Anish-A-18/Wireless-Power-Transmission/Presentation+Video/quadFinal.jpg

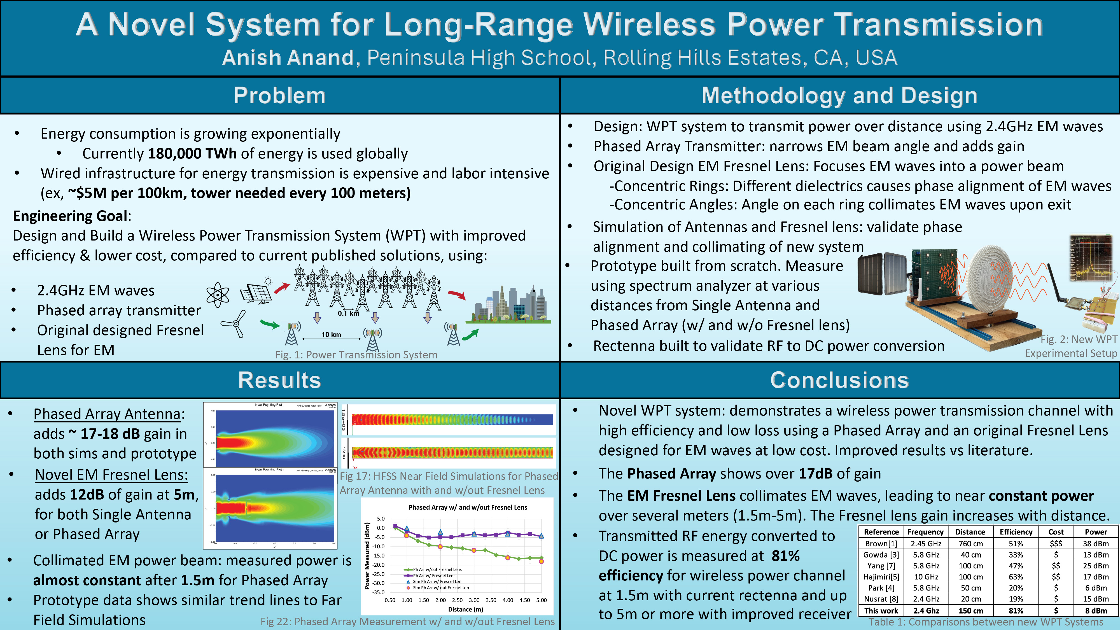
Presentation+Video/quadFinal.jpg
