Anish-A-18/Wireless-Power-Transmission/Presentation+Video/Video.md

Watch the video (https://youtu.be/sPy0BPeNYaU)
