Anish-A-18/Wireless-Power-Transmission/Presentation+Video/WPT_ISEFpreziFINAL.pdf

## PHY031

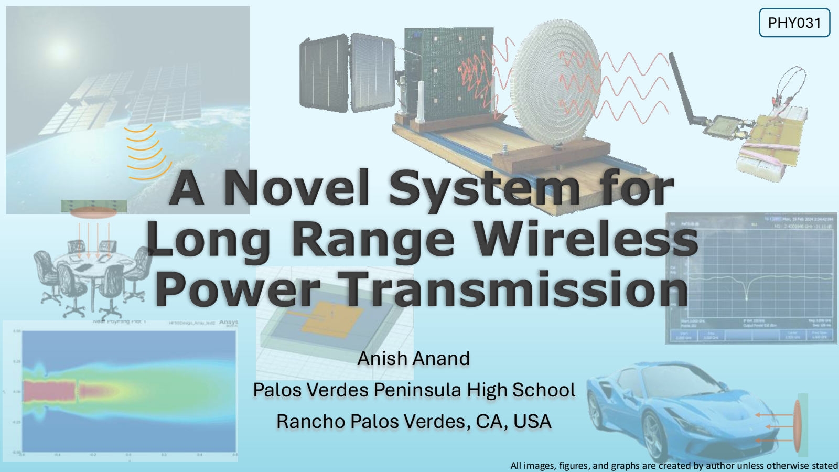
[picture p2: page 1]

# A Novel System for Long Range Wireless Power Transmission

# Anish Anand Palos Verdes Peninsula High School Rancho Palos Verdes, CA, USA

All images, figures, and graphs are created by author unless otherwise stated

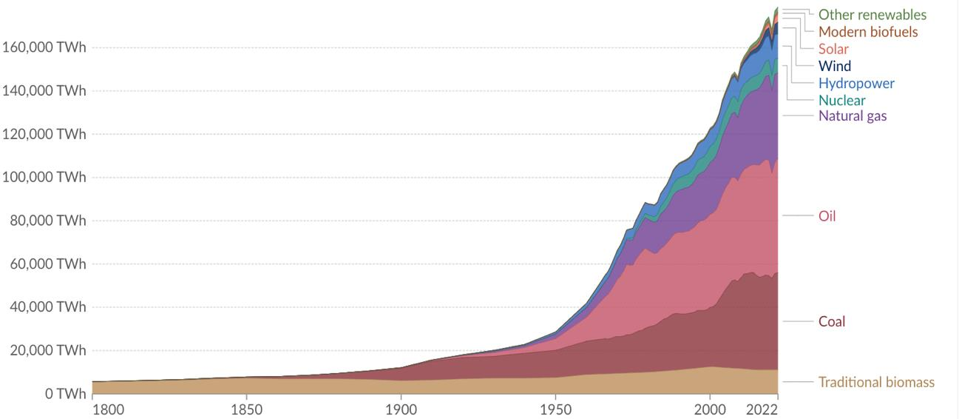
[picture p3: figure]

Fig 1: Global Energy Usage over Time in years Source: Energy Institute - Statistical Review of World Energy (2023), Smil (2017)

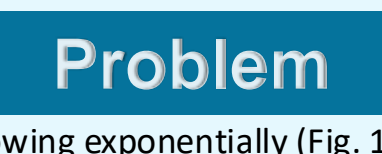
[picture p4: figure]
Problem

- Energy consumption growing exponentially (Fig. 1)
- Population growth and new power-hungry technologies drive greater energy usage. Currently 180,000 TWh of energy is used globally
- Wired infrastructure for energy transmission is costly, limiting choices
- Expensive: ~$5M per 100 km. Power tower needed every 100 meters
- Limitations: New clean energy plants can’t be too far from cities. Older buildings need extensive re-wiring for more power transmission
- Current Wireless EM Solutions: not adopted due to poor efficiency. Energy is lost as a function of distance (quadratic decay, Friis transmission equation)
- Goal: Efficient power transmission wirelessly over distance, via beaming EM waves where energy stays near constant over distance
- My Original Wireless Power Transmission (WPT) System:
- 2.4GHz EM waves transmit power: selected as optimal mix of size and efficiency, while minimizing atmospheric impact
- Components: Phased Array & Original Fresnel Lens designed for EM transmission.
- Efficiency: WPT phase aligns and collimates EM power waves, resulting in near constant power over distance.
- Wireless Cost: long range cost reduced 100x (~$50K per 100 km) with towers using line-of-sight transmission ~every 10,000 meters. Shorter distances: minimal remodel costs

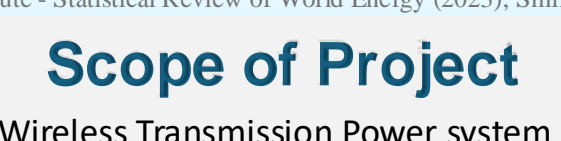
[picture p5: figure]
Scope of Project

- Novel Wireless Transmission Power system using 2.4GHz EM waves has been invented
- An original design for a for a Fresnel lens to use with S-band microwaves (2.4GHz) is designed and 3-D printed
- Phased Array Transmitter is designed and implemented using IC components and Printed Circuit Board (PCB)
- Transmitter and Lens elements were studied and simulated with Matlab and an EM Solver (HFSS)
- A Rectenna designed with copper tape and ICs on a FR4 PCB to test RF conversion to DC Power
- Prototype measurements taken and compared to simulation data and to current literature

**This work was performed in a home setting**

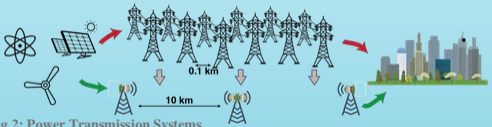
[picture p6: figure]

Fig 2: Power Transmission Systems

Fig 3: WPT Array and
Lens Transmitter

# Engineering Goals and Research Hypothesis

Engineering Goals:
- Design and Build a Wireless Power Transmission System (WPT) with improved efficiency & lower cost, compared to present day published solutions.
- Build a Rectenna based receiver to show how the WPT can create DC energy to power LED lights
Research Hypothesis:
- An original EM Fresnel Lens design as part of the WPT system can provide significant gain from additional phase alignment and collimation of the EM waves. This innovation, coupled with phased array transmitters, will improve WPT power efficiency over distance.

Current Wireless Power Transmission Systems
- Commercial WPT: based on induction charging. Works well over very short distances (<4cm) with efficiencies around ~80%
- RF Harvesting: for very low power. RF communication signals converted to power with IOT sensors. newly emerging field.
- EM based WPT: currently being researched for distances of 1-2 meters with published literature efficiencies of 20-35%
- Very Long Distance WPT: in experimental phase, such as Cal Tech’s Solar Power MAPLE (Microwave Array for Power Transmission)
- My research: new methodology to improve efficiencies compared to current literature for EM based WPT, so can be used for medium distance

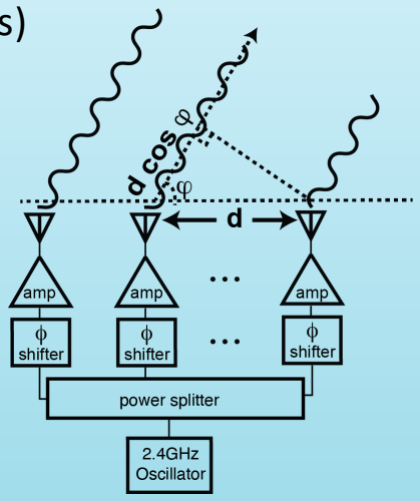
[picture p7: figure]

(medical device implants, wireless charging across a room) and stepping-stone for long distance (clean energy power sources)
Phased Array Transmitter
- An array of power amplifiers and antennas used to narrow and direct an RF beam
- Key advantage: increases power gain transmission by N²
instead of N.
- Each antenna sends out EM waves with different phase shifts. Through constructive interference, these waves combine to produce high gain in a specific direction following Euler’s equations:

R φ, θ = σn,m
e

−j2π

d
λ

cosθ((m−1)sinφ+(n−1)cosφ)

Wn, m χ, φ = e

+j2π

d
λ

cosφ((m−1)sinχ+(n−1)cosχ)

W ∗ R φ, θ = σn,m
e

+j2π

d
λ

cosφ((m−1)sinχ+(n−1)cosχ)
∗ e

−j2π

d
λ

cosθ((m−1)sinφ+(n−1)cosφ)
Where R ϕ, θ is real space, W are phase shifts, χ, φ is the constant beam steer angle, and λ is the wavelength

(Eq 1)

(Eq 2)

(Eq 3) | Fig 4: Phased array transmitter where d is
| the distance between antenna elements, and φ is the angle of the beam direction

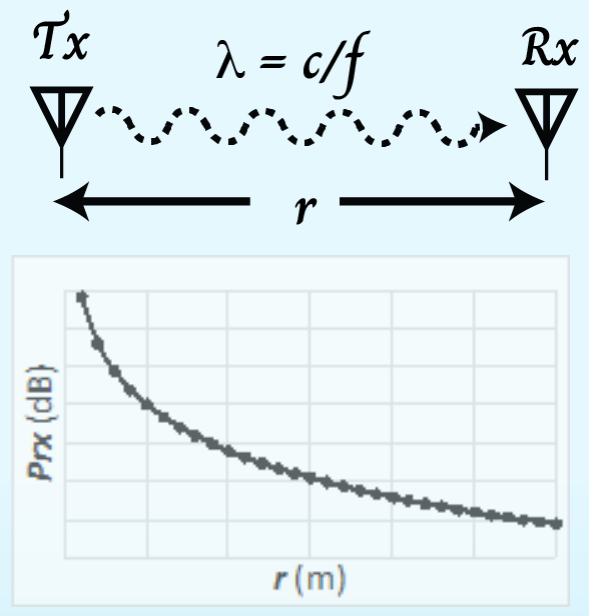
[picture p8: figure]

Friis Transmission Equations:

- Friis Equation for Transmission: determines radiated and received power based on gain and power transmitted, wavelength of radiated power, and distance between the transmitter and receiver antenna. Gtx and Grx are the gain of the transmitter and receiver antenna, r is the distance between the transmitter and receiver, λ is the wavelength of the signal and Ptx is the transmitted power. A wavelength, λ, is defined as speed of light, c, divided by the frequency, f.

Pradiated =

GtxPtx
4πr
2 | Prx =

GrxPradλ

2

4π

=

GtxGrxPtxλ

2

(4πr)

2

- Power Transmission: From Friis equation, received power decreases with: 1) farther distance (by 1/r² ) and
2) higher frequency (shorter wavelength) waves.
- Friis Equation with Phased Array: for N antennas, the Transmitter gain increases by N²
| Prx = N2 GtxGrxPtxλ

2

| (4πr)

2
Fresnel Lens:
- Designed initially by Bernard Fresnel in 1822 to increase the light intensity for light houses, preventing ship crashes
- Replaces curved surface of conventional optical lens replaced with a series of angular concentric rings (Fig 6)
- Collimates and magnifies the light (Fig 7) with much less material than a standard optical lens

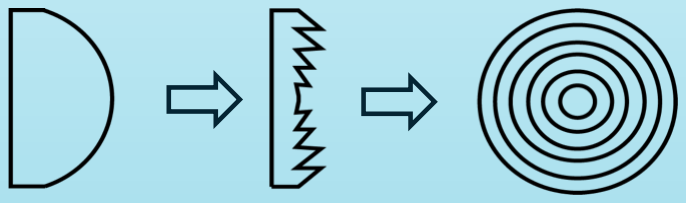
[picture p9: figure]

- Current EM Fresnel Lens: Designed for EM waves but limited to high frequency Ka–band and V-band millimeter wavelength band (27-60 GHz). Lower frequencies increase the lens thickness and material cost, because lens thickness is equivalent to the wavelength of the EM wave.
Fig 6: Curved lens can reduce to Fresnel Lens with concentric Rings | Fig 7: Fresnel Lens collimates and magnifies light waves

(Eq 3)

(Eq 4)

Fig 5: Wireless transmission between a transmitter(Tx) and receiver(Rx) where is the wavelength, c is the speed of light, and f is the frequency of the EM wave . Plot shows how power decays as function of distance.

- Design WPT System with Phased Array and EM Fresnel Lens at 2.4GHz :
- 2.4GHz (Microwave S-Band Frequency): Optimal EM frequency due to ideal mix of higher power efficiency, lower cost and minimal atmospheric loss. Lower frequencies costlier due to increased transmitter size. Higher frequencies are inefficient with more power loss.
- Phased Array: 1) narrows EM beam angle with gain and 2) can use smaller diameter/thinner Fresnel lens (half power beamwidth)
- Original EM Fresnel Lens: Vertically phase aligns and collimates EM waves into a focused EM beam, thereby increasing power transmission.
- Build: prototype WPT system with lower power to determine effectiveness of design as proof of concept
- 9-element Phased array transmitter that provide 0 dBm of RF power each
- Original 2.4GHz EM Fresnel lens that is 3D printed
- Mountable system to test Transmitter and Lens with correct focal distance
- Build: Rectenna to determine enable RF to DC power conversion
- Research Requirements to Scale WPT: for each use case, determine sizes of phased array and Fresnel lens needed for WPT system

# Design of 2.4GHz Phased Array Transmitter

- Phased Array Transmitter: narrows EM beam angle and adds gain
- Voltage control oscillator creates 2.4GHz signal, amplifiers increase gain, power splitters split the signal to 9 separate paths, and antennas are used to radiate power
- Phase shifters are used to change phase and align phases at output
- Components for Printed Circuit Board (PCB): selected based on frequency and gain
- PCB Design: using Altium software with RF techniques
- PCB Fabrication: at Advanced Circuits on 2-layer FR4 board
- | Phase alignment calibration: completed using Network Analyzer | Fig 8: The 2 boards used for the phased array transmitter split as (1) phased aligned frequency generation and (2) antenna array

# Design of Original 2.4GHz EM Fresnel Lens

# Design of Rectenna

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
εr = (εrmax−1)

m² − s

2
m² + 1

L0 + εr0d0 = Ln + εrndn

=

L0
cosθn1

+ εrn

d0
cos(θn1/ εrn)

Matched at 2.4GHz
with S11 = -30dB

υεR =

c
εR

, λεR =

υεR
f

. Snell

′
s Law:

sinθ1
sinθ2

=

υ1
υ2

=

ε2
ε1
(Eq 5) | (Eq 6)

(Eq 7)

- Rectenna: built with copper tape on FR4 material (Fig 12)
- Antenna matching: 50 Ohm matching for Rectenna input
- | Diodes: used to rectify EM waves to generate DC power | 1.4nH | 2.2pF

Fig 9: Lattice structure for Fresnel Len and table to generate dielectric constants for each Fresnel Zone

Fig 10: Fresnel Len made of concentric rings and angles designed in Fusion 360

Fig 11: Fresnel Len design methodology to align phase and collimate EM waves at
output of lens

Fig 12: Rectenna Design, Matching methodology and S11 plot after matching Rectenna input

- Lens Goal: efficient EM power transmission due to 1) phased alignment of waves and 2) angling of waves into a collimated EM beam (Fig 11).
- Novel EM Lens: 1) Concentric Rings (unique design) 2) Concentric Angles (never reported for EM)
- Concentric Rings: Phase aligns EM waves as they exit the Lens (Fig 11). Each ring has a
different dielectric (Fig 10), determined by original formula (Eq 6). Desired dielectrics
obtained in 3D printing via lattice structure with differing densities (Fig 9)
- Concentric Angles: to collimate waves, Snell’s law (Eq 7) used to derive an angle for each ring (Fig 10)
- Lens size: 20cmX1.2cm determined by Phased Array Half-Power Beam Width (34 o
), focal distance
(30cm), and dielectric constant of ABS material (εrmax = 5.0 at 2.4GHz) which was then 3-D printed

hx

Theoretical Calculations:

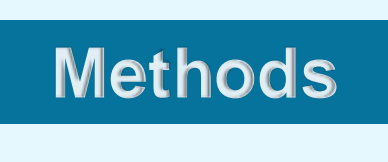
[picture p10: figure]
Methods

- Friis Equations for transmission used to determine expected theoretical power as a function of distance
Simulation Method:
- Original Matlab code written to determine Phased Array Antenna gain
- Simulation of Antennas and EM Fresnel lens conducted in an EM simulator, Ansys High Frequency System Simulator (HFSS), to determine the validity of phase alignment and collimating properties of the Fresnel Lens for focal distance of 30cm using 2.4GHz EM waves.

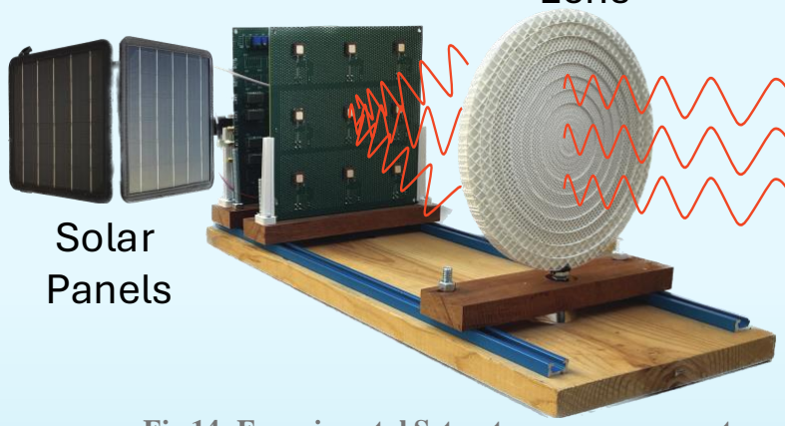
[picture p11: figure]
Solar Panels
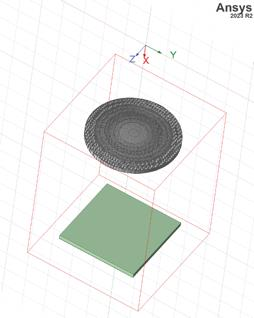
[picture p12: figure]
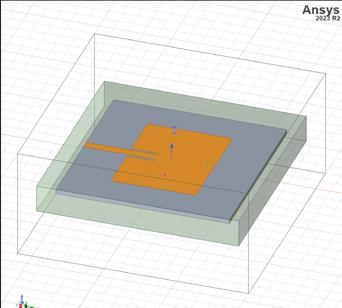
[picture p13: figure]
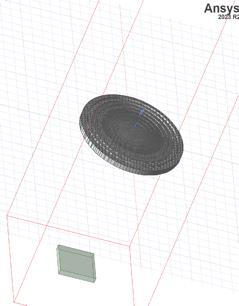
[picture p14: figure]
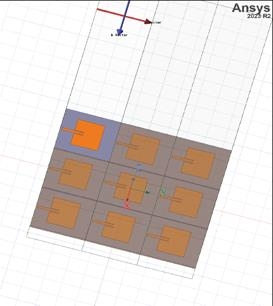
[picture p15: figure]

Independent Variables:

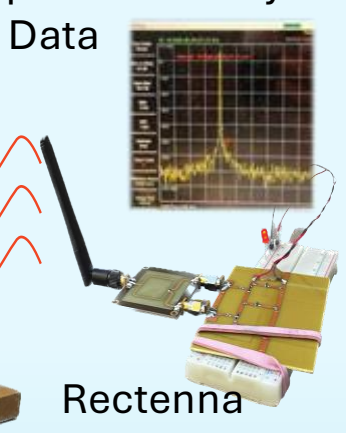
[picture p16: figure]
Data; Rectenna

- Frequency of EM wave, power transmitted, phased array gain, rectenna gain
Dependent Variables:
- Radiated and Received power over distance Constants:
- Focal distance, temperature and humidity, measurement apparatus and equipment Controls and comparisons:
- Theoretical and simulated calculations vs experimental data from prototype

## Fresnel Lens

## Transmitter

### Antenna Array

Experimental Method (Prototype):
- Measurements using spectrum analyzer at various distances from Single Antenna and Phased Array (with and without Fresnel lens) taken to determine the power transmission
- Rectenna used to determine RF to DC Power conversion at distance for WPT System

Data Analysis Method:
- Measurement data compared to theoretical expectation for power transmission
- Receiver antenna limitations are calibrated to determine true performance of WPT system energy transmission in wireless channel

## Spectrum Analyzer

Fig 13: The (a) patch antenna, (b) patch antenna with Fresnel lens, (c) phased array, and (d)phased array with Fresnel lens were modeled in HFSS to provide near field and far-field simulations data

Fig 14: Experimental Setup to measure power transmitted in various conditions of antenna, phased array, and Fresnel lens. Solar Panel is used as power source for antenna array

(a) | (b) | (c) | (d)

# Simulation Results

Matlab Simulations for Phased Array
- Simulations for 9 element phased array shows gain of 18dB and angle of beam 34o (Fig 15)
HFSS Simulations
- EM Simulations validate gain from Fresnel Lens due to phase alignment and collimation
- Near Field Simulations: phased array shows 18dB of gain. Addition of Fresnel Lens results in 5 dB of gain at
0.5 meter and 8 dB of gain at 1 meter
- Far Field Simulations: Fresnel lens gain increases with distance (Table 1). Adding EM Fresnel lens to Phased
Array results in nearly constant power over 10m, which is not seen in Phased Array alone. | Fig 15: Matlab simulation of phased array transmitter

Fig 16: HFSS Near Field and Far Field Simulations for Single Antenna with and w/out Fresnel Lens

Fig 17: HFSS Near Field Simulations for Phased Array Antenna with and w/out Fresnel Lens

0 dB

18 dB | 23 dB

5 dB

4 dB | 12 dB

Single Antenna Simulation (Near Field)
Irradiated Power (W/m2) | Single Antenna Simulation (Far
| Field)
| Electric Field (V/m)

Single Antenna w/ Fresnel Lens (Near Field) Simulation - Irradiated Power (W/m2)

Phased Array Simulation (Near Field) Irradiated Power (W/m2)

Phased Array w/ Fresnel Lens (Near Field) Simulation - Irradiated Power (W/m2)

Single Antenna w/ Lens
Simulation (Far Field) Electric Field (V/m)

Phased Array Simulation (Far Field)
Electric Field (V/m)

Phased Array w/ Lens Simulation (Far Field) Electric Field (V/m)

Table 1: Electric Field estimated Data

0.5 m | 0.5 m
0.5 m | 1.0 m | 0.5 m | 1.0 m

Fresnel Lens
adds 5 dB gain
at 0.5m

Fresnel Lens adds 8
dB gain at 1m

Fresnel Lens + Phased Array maintains nearly constant power in wireless channel

5 m

10 m

# Prototype Results of Single Antenna and Phased Array Transmitter

- Measurements: recorded 3x at each distance using a spectrum analyzer
- Single Antenna: power transmission follows Friis Transmission equation well up to 2 meters in distance (Fig 18)
- Phased Array Transmitter: 17dB gain compared to a Single Antenna at 5 meters of distance (Fig 19)
- Prototype Results match Simulations: Gain is within 1dB of expected value of 18dB based on Matlab & HFSS simulations
- Gain validates Phase Array is calibrated correctly
- Loss over distance is similar for Phased Array as Single Antenna with measurements from dipole antenna receiver
- Antenna Correction Factor: beyond 2 meters, both Single Antenna and Phased Array display lower than expected results, due to partial field
cancellation of dipole antenna. All antennas show some loss compared to predicted measurements, requiring a correction factor.
- To model ideal receiver: receiver antenna is calibrated with multiple independent signals across measured distance

Antenna Correction Factor d = −0. 36d

3 + 3. 04d

2 − 3. 81d + 0. 6

- Results of Antenna Correction Factor: mean measured values of both single antenna and phased array antenna are within the 3 standard deviations of expected values from Friis Transmission equation (Fig 20), validating Antenna Correction Factor formula .

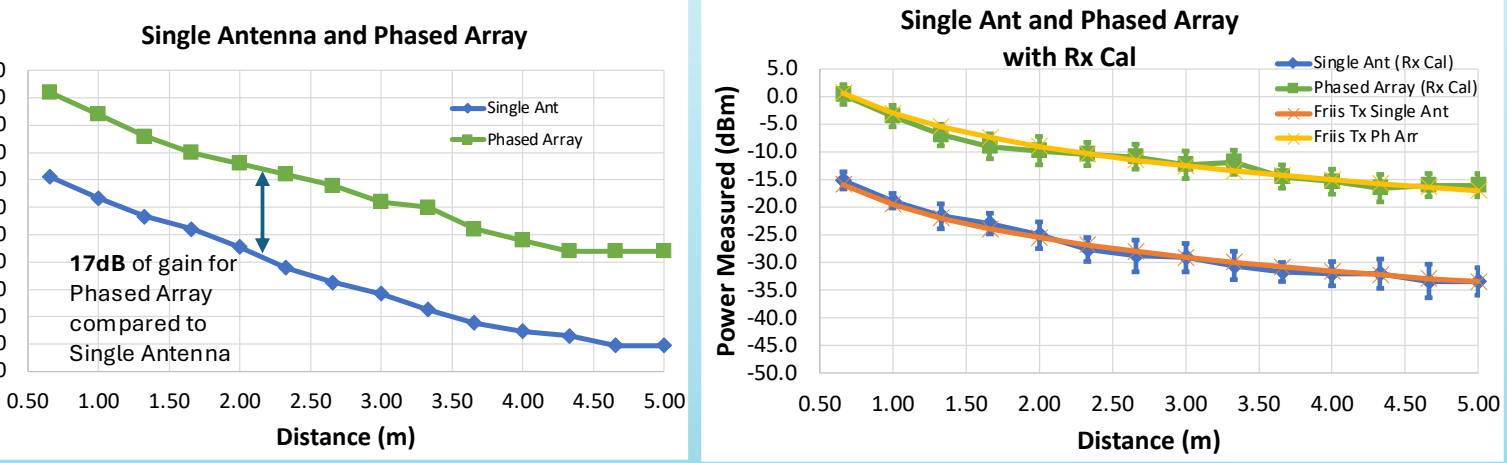
[picture p17: figure]
Distance (m); Single Antenna and Phased Array; Single Ant; Phased Array; Power Measured (dBm); Single Ant and Phased Array; with Rx Cal; Single Ant (Rx Cal); Phased Array (Rx Cal) Friis Tx Single Ant Friis Tx Ph Arr; 17dB of gain for Phased Array compared to Single Antenna
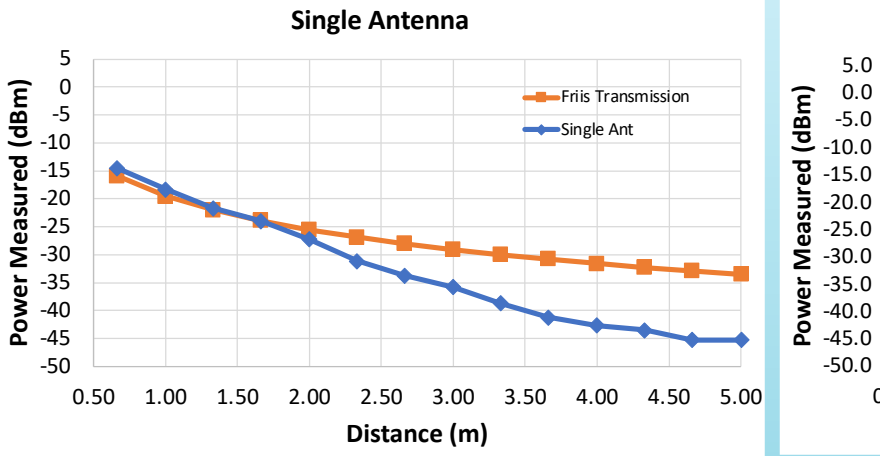
[picture p18: figure]
Power Measured (dBm); Distance (m); Single Antenna; Friis Transmission; Single Ant
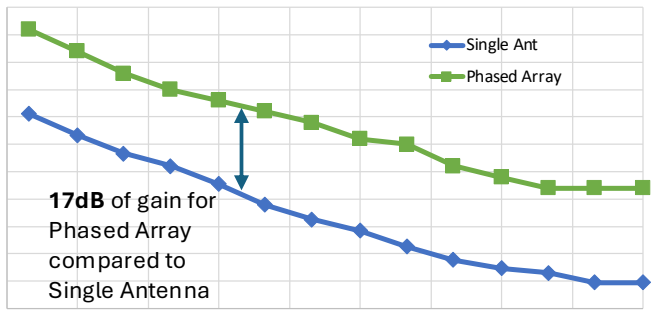
[picture p19: figure]

Fig 18: Single Antenna Measurement and Theoretical Data | Fig 19: Single Antenna and Phased Array Measurement | Fig 20: Single Antenna and Phased Array Measurement after Corrections

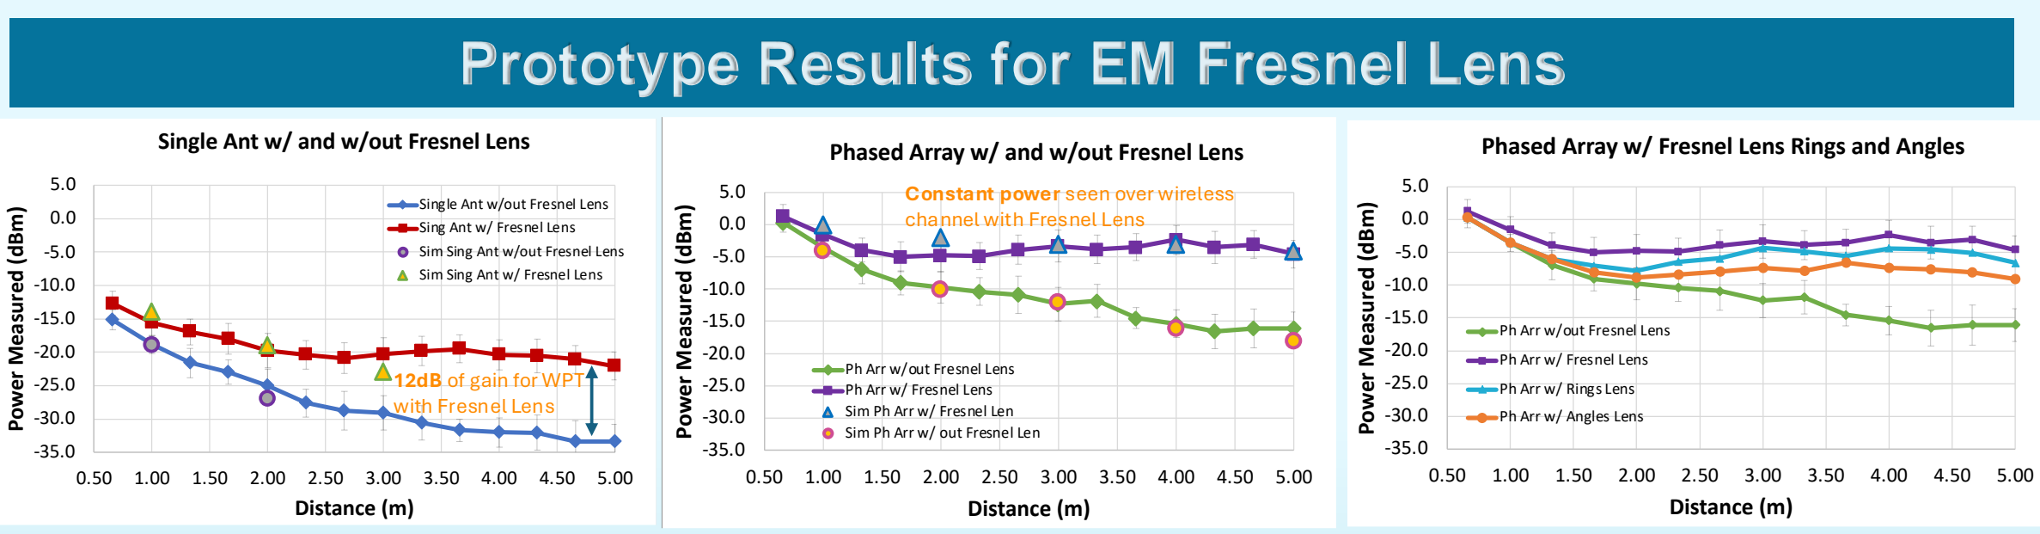
[picture p20: figure]
Power Measured (dBm); Distance (m); Phased Array w/ and w/out Fresnel Lens; Ph Arr w/out Fresnel Lens Ph Arr w/ Fresnel Lens Sim Ph Arr w/ Fresnel Len Sim Ph Arr w/ out Fresnel Len; Single Ant w/ and w/out Fresnel Lens; Single Ant w/out Fresnel Lens; Sim Sing Ant w/ Fresnel Lens; Prototype Results for EM Fresnel Lens; Ph Arr w/out Fresnel Lens; Ph Arr w/ Fresnel Lens; Ph Arr w/ Rings Lens; Ph Arr w/ Angles Lens; 12dB of gain for WPT with Fresnel Lens; Constant power seen over wireless channel with Fresnel Lens

0.50 1.00 1.50 2.00 2.50 3.00 3.50 4.00 4.50 5.00 0.50 1.00 1.50 2.00 2.50 3.00 3.50 4.00 4.50 5.00

Sing Ant w/ Fresnel Lens Sim Sing Ant w/out Fresnel Lens

- EM Fresnel Lens Results:
- Gain: Lens adds 12dB of gain at 5m, for both Single Antenna or Phased Array (Fig 21, 22)
- Collimation: measured power remains almost constant after 1.5m for Phased Array (Fig 22,23), showing EM waves are phase aligned & collimated due to Lens
- Prototype Results Compared to Far Field Simulations: show similar trend lines (Fig 22)
- Breakdown of Gain from EM Fresnel Lens:
- Concentric Rings component: contributes 59% of total gain due to phase alignment.
- Concentric Angles component: contributes 41% of total gain due to collimation (Fig 24)

Efficiency of WPT System (RF to DC power):
- Phased array data correlates with transmitted RF power of 8 dBm
- Rectenna output at 1.5 meter is 1.7 V and load current of 3 mA
- PTX-RF to PRX-DC is measured at 81% efficiency (RF to DC power)

Phased Array w/ Fresnel Lens Rings and Angles

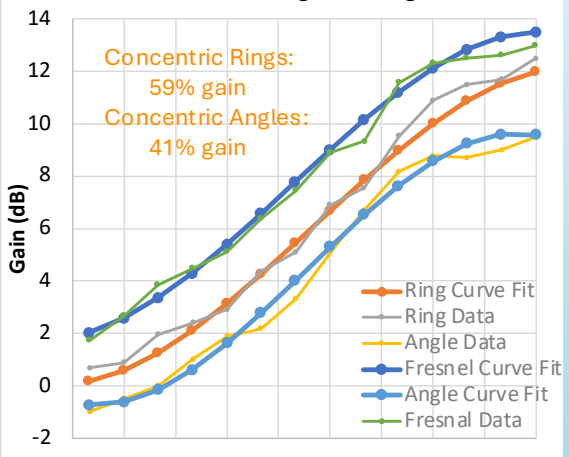
[picture p21: figure]
Gain (dB); Ring Curve Fit Ring Data; Angle Data Fresnel Curve Fit Angle Curve Fit Fresnal Data; Concentric Rings:; Concentric Angles:; 59% gain; 41% gain

0.5 1.0 1.5 2.0 2.5 3.0 3.5 4.0 4.5 5.0 Distance (m)

Gain of Fresnel, Ring, and Angle Lens

Fig 21: Single Antenna Measurement w/ and w/out Fresnel Lens | Fig 22: Phased Array Measurement w/ and w/out Fresnel Lens | Fig 23: Phased Array Measurement with various configurations of the Fresnel Lens

Fig 24: Gain measurements of Phased Array with various configurations of the Fresnel Lens Gain measurements are curve fitted to estimate impact of each Fresnel Lens Component

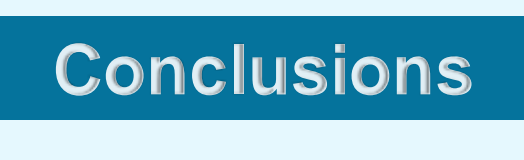
[picture p22: figure]
Conclusions

- A novel 2.4GHz WPT system is designed, simulated in Matlab and HFSS, built from scratch, and tested
- The novel WPT system demonstrates that a wireless power transmission channel with high efficiency can be developed with minimal loss using a Phased Array and an original Fresnel Lens for EM designed from first principles
- The Phased Array shows over 17dB of gain (~50x power increase compared to baseline single antenna), where 18dB is theoretically possible
- The EM Fresnel Lens maintains constant power over several meters (from 1.5m to 5m). The Fresnel lens gain increases with distance. At 5m, the gain is over 12dB (~16x power increase compared to baseline wihtout Fresnel Lens).
- Concentric Rings portion of EM Fresnel Lens use a new methodology
for 3D printing and provides ~60% of the total Gain
- Concentric Angles portion of EM Fresnel Lens has never been reported
for EM Lens and provides ~40% of the total Gain
- The EM Fresnel Lens provides over 12dB gain (~16x power increase). A similar gain would require a 4x larger Phased array. By reducing the number of Phased Array elements by ~ 75%, there is less thermal loss and reduced cost
- A matched charge rectifying Rectenna was designed from scratch to convert
the RF energy transmitted to DC power
- RF energy transmitted converted to DC power PTX-RF to PRX-DC is measured at 81% efficiency for wireless power channel at 1.5m with current rectenna and up to 5m or more with improved receiver antenna
- My WPT system provides better efficiency of wireless power transmission at a lower cost, compared to current literature (Table 1)

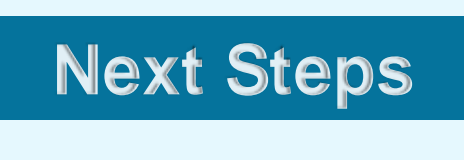
[picture p23: figure]
Next Steps

- To improve close-in losses: 1) Phased Array will have more elements (4X4) to reduce the Half Power Beam width (HPBW) and 2) EM Fresnel lens will be re-designed with a larger diameter to capture fringe EM waves that are escaping around edges in near-field
- To minimize the Fresnel Lens diameter: the EM lens will be re-designed for a closer near-field focal point
- Improved Rectenna antenna design with larger aperture to more efficiently receive EM power over longer distances

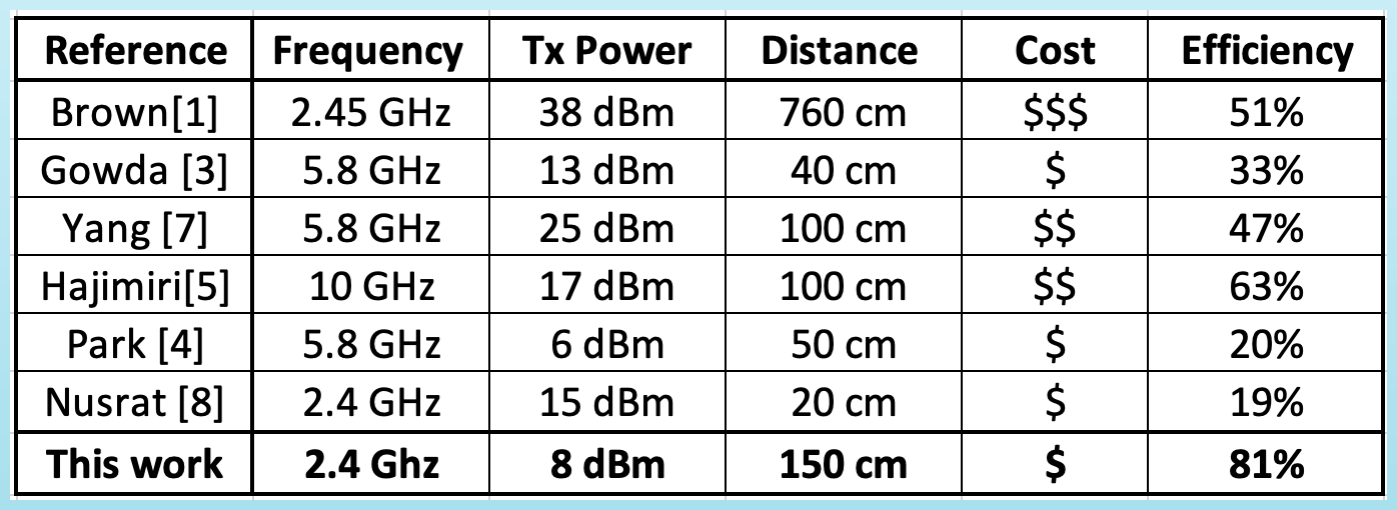
[picture p24: figure]

Table 1: Comparison of this work to reported WPT systems. The low cost ($) systems have simple antenna systems, the medium cost ($$) systems have expensive antenna systems, and the high cost system of the historical Brown design (3-meter diameter parabolic antenna) is extremely expensive

# Potential Use Cases: Short, Medium, and Long Range

Wireless charging of medical devices (short distance): Deep implants where induction charging in inefficient and unsafe. Avoids repeated surgeries for battery replacement since battery has a limited lifespan.
- Pacemaker: requires 100mW of power annually. WPT charging can be done annually at doctor’s office in 10-minute span using power levels like the prototype of 10dBm (10mW)
- Deep brain implants: requires 925mWH per 100 days, which corresponds to 10.2mWH per day. Currently patients need to wear inductive charging collar 30 minutes daily or 4 hours weekly, which cannot be done during sleep. Using the prototype, 13dBm (20mW) of power would be transmitted, fully charging the device over a 5-hour period during sleep.
Wireless charging in indoor and outside setting (medium distance): Requires larger arrays and lenses
- Indoor Conference Room: Wireless charging of phones and laptops requires 100W WPT system, which can be achieved by 32 element phased array with each element providing 20 dBm of power
- Electric Car Charging: Requires 30kWH per 100 miles. A WPT system with a 128-element phased array where each element provides 30dBm (1W) of power can provide required power
Transporting energy from power plants to inner city (long distance):Requires larger arrays and lens and receivers
- Small City: to power 10,000 homes each using 10,000kWH annually, a system of 1024 array elements with 40dBm (10W) per element could transmit power from clean energy source to central receiver with battery
- Solar Power from Space: Solar panels on satellites in low Earth orbit at ~200km (non-stop production). Good option to charge power stations around the world. Highly efficient, non-destructive green energy

Acknowledgements to organizations that supported my research:
Mini-Circuits – donated surface mount devices for the phased array transmitter (VCO, PAs, Power Splitters, Phase Shifters, Advanced PCB – donated PCB fabrication and soldering for phased array transmitter , Magnetika – provided HFSS and use of 3D printer on weekends All images are Original except if noted

Credit: Mark Garlick/ Science Photo Library

1. W. C. Brown, "The History of Power Transmission by Radio Waves," in IEEE Transactions on Microwave Theory and Techniques, vol. 32, no. 9, pp. 1230-1242, September 1984
2. H. D. Hristov, et al, "Design Equation for Multidielectric Fresnel Zone Plate Lens," in IEEE Microwave and Wireless Components Letters, vol. 22, no. 11, pp. 574 -576, Nov. 2012,
3. V. R. Gowda, O. Yurduseven, et al, "Wireless Power Transfer in the Radiative Near Field," in IEEE Antennas and Wireless Propagation Letters, vol. 15, pp. 1865-1868, 2016
4. J. H. Park, N. M. Tran, S. I. Hwang, et al, "Design and Implementation of 5.8 GHz RF Wireless Power Transfer System," in IEEE Access, vol. 9, pp. 168520-168534, 2021
5. A. Hajimiri, B. Abiri, et al, "Dynamic Focusing of Large Arrays for Wireless Power Transfer and Beyond," in IEEE Journal of Solid-State Circuits, vol. 56, no. 7, pp. 2077-2101, July 2021
6. A. Fikes et al., "The Caltech Space Solar Power Demonstration One Mission," 2022 IEEE International Conference on Wireless for Space and Extreme Environments (WiSEE), Winnipeg, MB, Canada, 2022, pp. 18-22
7. Q. Yang, H. Zhang and B. Wang, "Beamforming Design for Integrated Sensing and Wireless Power Transfer Systems," in IEEE Communications Letters, vol. 27, no. 2, pp. 600-604, Feb. 2023
8. Nusrat, T., Roy, S., Lotfi-Neyestanak, Noghanian, S. (2023). Far-Field Wireless Power Transfer for the Internet of Things. Electronics, 12(1), 207. https://doi.org/10.3390/electronics12010207

Fig 25: WPT for deep
medical implants

Fig 26: WPT for indoor
conference room

Fig 27 (up): WPT for
charging electric vehicles

Fig 28 (left): WPT for long-range solar transmission
