Anish-A-18/Wireless-Power-Transmission/ConferencePaper/rwwStudent_2024_FINAL.pdf

# A Novel Long Range Wireless Power Transmission System Using Fresnel Lenses for S-band EM Waves

Anish Anand
Palos Verdes Peninsula High School Rancho Palos Verdes, CA, USA anishmail2007@gmail.com

Abstract— As energy consumption rapidly increases, there is a need for new and innovative power transmission systems. Wireless Power Transmission (WPT) systems could solve this dilemma, but face limitations due to high energy loss over distance. This project seeks to overcome these challenges by developing a WPT system that transmits energy over distance with minimal loss, using a Phased Array transmitter combined with a novel 3D printed Fresnel Lens. Designed with a high dielectric ABS and consisting of 2 parts, the original Fresnel Lens phase aligns and then collimates EM waves transmitted at 2.4GHz, allowing for efficient wireless energy transmission. After simulations, a prototype consisting of a Phased Array transmitter, Fresnel Lens, and rectenna receiver was designed and fabricated to test design methodology and efficiency. The novel EM Fresnel lens shows promising results, adding 12dB gain at 5m and nearly constant energy in the wireless channel with minimal loss over distance.

Keywords—Wireless power transmission, phased arrays, Fresnel Lens, 3-D printing, rectenna

I. INTRODUCTION
Worldwide energy usage is growing rapidly, due to population growth and new power-hungry technologies. However, building wired infrastructure for energy transmission is costly, limiting deployment of clean energy plants. For example, the cost to build wired infrastructure is over $5M per 100km whereas wireless infrastructure is less expensive (i.e. costs can be reduced by 100x compared to wired), allowing for new sources of energy in previously inaccessible locations.

Wireless EM solutions for power transmission have not been adopted due to poor efficiency (Friis transmission loss) and high costs [1]. This research studies how to improve wireless power transfer over longer distances, with lower costs and better efficiencies, using 2.4GHz S-band EM waves.

A novel long range wireless power transmission (WPT) system was designed with a Phased Array and a 2-part Fresnel Lens. The Phased Array narrows the EM wave beamwidth and points the beam in a specific direction, resulting in a WPT that is smaller, less expensive to build, and has higher power transmission. The Fresnel Lens, designed for EM waves with 2 original parts, first phase aligns and then collimates the EM waves, allowing for efficient energy transfer over distance.

II. BACKGROUND INFORMATION OF FRESNEL LENSES
EM waves for wireless power transmission are governed by the Friis equation, losing power quadratically as a function of distance. To minimize the significant drop in power over distance, a new system must be designed to counteract this loss.

The Fresnel Lens was originally used to focus and amplify light. The curved surface of a conventional optical lens is replaced with a series of concentric angular rings, thereby collimating and amplifying the signal with less material (Fig 1).

Fig 1. Optical Lens vs Fresnel Lens with concentric rings
Fresnel Lenses designed for EM waves are limited to high frequency Ka–band and V-band millimeter wavelengths (27-60 GHz) in the literature [2]. As lens thickness is equivalent to the wavelength of the EM wave, lens thickness and material costs increase for lower frequencies, resulting in less research around lower frequencies. In this research, new design methods minimize the size and cost of the Fresnel Lens for 2.4GHz.

III. NOVEL FRESNEL LENS DESIGN AND FABRICATION
This research incorporates new design methods for the Fresnel Lens in the S-band of the spectrum. First, by combining the novelFresnel Lens with a Phased Array,the HPBW required by the Lens is smaller, resulting in a smaller diameter Lens with greater focusing. The Lens is also designed with a focal length on the border between the near-field and the far-field of the Phased Array.Second, a high dielectric ABS plastic is used with a S-band dielectric of 5, so that Lens can be built using 3D printing. Third, the Lens consists of two independent parts, first to phase align the angular beam and second to collimate the outgoing waves into a beam. Phase alignment, as the incoming waves enter at various angles, is accomplished by differing dielectrics in each concentric ring of the Lens. Collimation results from the differing concentric angles on each ring.

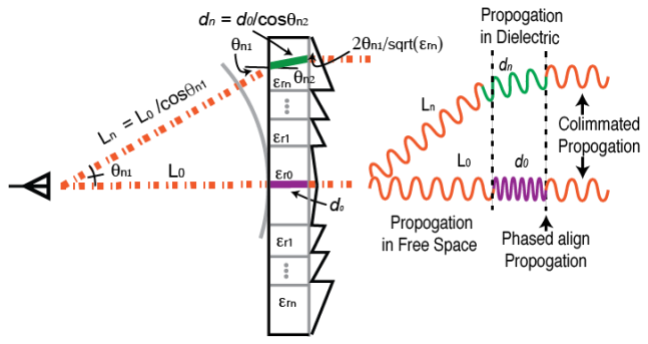
[picture p25: figure]

Fig 2. Fresnel Len design methodology to align phase and collimate EM waves at output of lens

A. Fresnel Lens Design
The novel Fresnel Lens (1) phase aligns the EM waves and then (2) collimates the EM waves into a beam, so the EM waves can travel longer distances with minimallosses. To achieve this goal the Lens combines a planar and angular Fresnel Lens (Fig 2). The angular Lens for EM has not been reported before and was developed solely in this research.

To phase align the incoming EM angular waves, the planar Lens is designed with concentric rings of different composite dielectric values, εrn. Each ring is considered a Fresnel Lens Zone. The dielectric value for each Zone is estimated based on the incident angle for each Zone, θn, focal length for the lens, L0, and thickness of the lens, d0, (Eq 1-3). After the incoming EM waves traverse each zone, they all exit phase aligned.

υεR =

c
√εR

(1)

λεR =

υεR
f

(2)

L0 + √εr0d0 = Ln + √εrndn

=

L0
cosθn1

+ √εrn

d0
cos(θn1/√εrn)

(3)

To collimate the now phase aligned EM waves (Fig 2), the angular Lens, with different angles for each concentric ring, re-angles the exiting waves into a collimated beam. Snell’s law determines the angle required for collimation for each Zone.

B. Fresnel Lens Fabrication
The fabricated Lens dimensions are determined by the specifics of the Phased Array. In this system, the half-power beam width of the phased array is 34o
, the focal distance is 30cm, and the ABS plastic dielectric is 5. These design parameters dictate a Lens size of 20cm and thickness of 1.2cm.

The combined planar and angular Lens (Fig 3) are designed using Fusion 360 to provide a stereo-lithography (STL) format of data for both 3-D printing and simulating the design.

Fig 3. Fresnel Len made of concentric rings and angles
designed in Fusion 360 Cad tool
A lattice structure creates the different dielectric constant for each Fresnel Zone [3]. The structure, based on a hole spacing “s” and a fill section “m”, results in different densities, translating into different dielectrics. Fig 4 shows a sample of the lattice structure, and the dielectrics required for each zone.

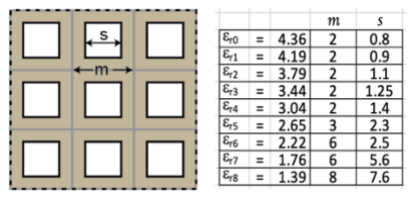
[picture p26: figure]

Fig 4. Lattice structure for Fresnel Len and table to generate dielectric constants for each Fresnel Zone

The density of the structure to create the dielectric constant is:

εr = (εrmax − 1)

(m² − s

2
)
m² | + 1 | (4)

Both the s and m dimensions need to be within the tolerance of the 3-D printer. The 3D printer’s maximum temperature, nozzle size, cooling rate and printing speed need to be accounted for.

IV. SIMULATIONS OF PHASED ARRAY AND FRESNEL LENS

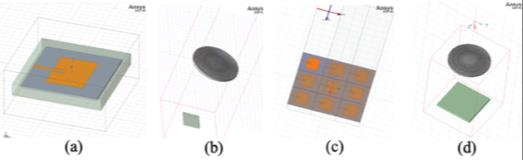
[picture p27: figure]

Fig 5. The (a) patch antenna and (b) patch antenna with Fresnel lens, (c) phased array, and (d) phased array with Fresnel lens were modeled in HFSS to provide near field and far-field simulations data.
EM simulations with HFSS were completed to determine the design methodology and system parameters of the Phased Array and Fresnel Lens, prior to printing the Lens. The Phased Array transmitter is designed using a single micro-strip patch antenna design and then arraying that element into a proposed PCB. The Fresnel Lens was imported into HFSS as STL files directly from the CAD tool. Fig 5 (a-d) are the drawn models of the Single Antenna with and without the Fresnel Lens, and the Phased Array with and without the Lens, respectively.

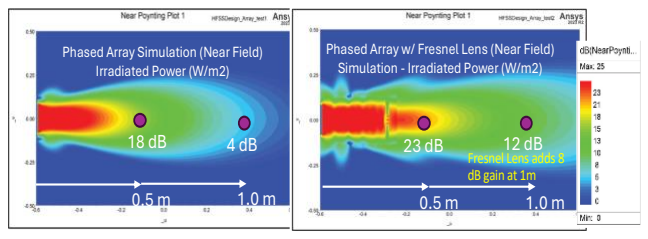
[picture p28: figure]
Phased Array Simulation (Near Field) Irradiated Power (W/m2); Simulation - Irradiated Power (W/m2); Fresnel Lens adds 8 dB gain at 1m

Fig 6. HFSS Near Field Simulations for Phased Array Antenna with and w/out Fresnel Lens
Near-Field simulations show a) the Phased Array adds18dB of gain compared to the Single element Transmitter and b) the Fresnel Lens adds 5dB of power at 0.5m and 8dB higher power at 1m distance, versus no Lens (Fig 6). In simulations, the Fresnel Lens improves the gain of this WPT system, with the gain increasing over distance, as expected with the Lens phase aligning and collimating the EM waves.

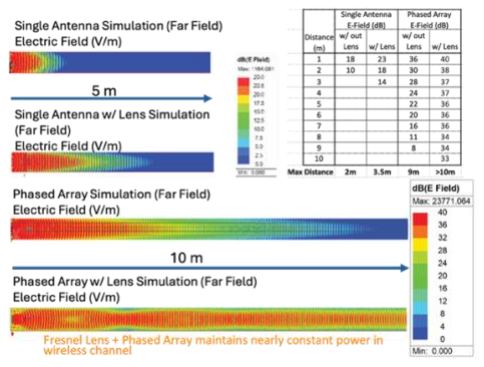
[picture p29: figure]

Fig 7. HFSS Far Field Simulations for Single Antenna with & w/out Fresnel Lens and for Phased Array Antenna with and w/out Fresnel Lens and Table of Electric Field estimated Data

Phased Array w/ Fresnel Lens (Near Field)

The Far Field simulations also demonstrate a) the Fresnel Lens gain increases with distance and b) the combination of the Phased Array and Fresnel Lens system provides almost constant power over 10m of distance (Fig 7). The far-field simulations closely match the prototype measurements, as seen in Section V.

V. EXPERIMENT AND RESULTS
The prototype for the WPT system consists of solar panels for energy generation, PCBs to create a 9-element Phased Array transmitter to provide 0 dBm with a HPBW of 34o
, the novel 2-
part Fresnel Lens with a focal distance of 30cm, and a spectrum analyzer and rectenna to determine the RF and DC power in the wireless channel as shown in Fig 8.

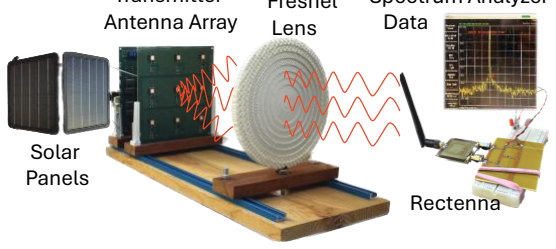
[picture p30: figure]
Data; Lens; Antenna Array; Solar Panels; Rectenna

Fig 8. Experimental Setup to measure power transmitted in various conditions of antenna, phased array, and Fresnel lens. Solar Panel is used as power source for antenna array
Experiments were conducted to determine the RF power level in the wireless channel as a function of distance. The assumption is that the transmitter can be designed efficiently for power transmission, with nonlinear components as well as antennas for the rectenna and spectrum analyzer [4,5]. To model power transmission of the transmitters to follow Friis equation in free space, an antenna correction factor is determined for the short-range antenna. The calibration factor for the antenna used in this research is shown below.

ACF(d) = −0.36d

3 + 3.04d

2 − 3.81d + 0.6 | (5)

Both the single element and the Phased Array match the Friis transmission equation results with antenna calibration. A measured improvement of 17dB with the Phased Array compared to the single element transmitter is seen (Fig 9).

Fig 9. Single Antenna and Phased Array Measurement after Corrections
Fig 10 shows the Fresnel Lens improves power transmission. Both the Single Antenna and Phased Array exhibit 12dB of gain at 5m distance. Further, the gain increases with distance, similar to the HFSS far field simulations. Additionally, after 1.5m, the Phased Array shows nearly constant power, as the Fresnel Lens phase aligns and collimates the transmitted power. Since the

Phased Array transmitter has a narrower HPBW compared to the Single Antenna, there is less initial loss prior to collimation (8dB loss for single transmitter vs 5dB loss for Phased Array).

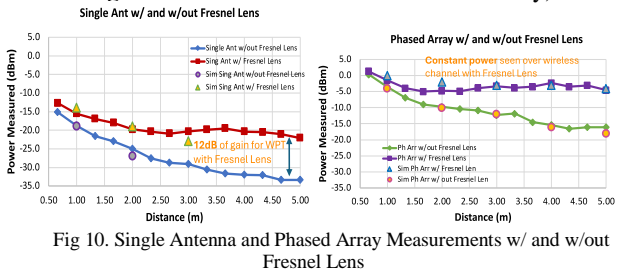
[picture p31: figure]
Fresnel Lens

Fig 10. Single Antenna and Phased Array Measurements w/ and w/out

Fig 11 shows the relative contribution between the 2 parts of the Fresnel Lens. The Ring Lens contributes 59% of the total combined Lens gain and the Angular Lens provides 41% of the total gain. Compared to the planar lens alone, the Angular Lens results in an additional 60% of gain.

Fig 11. Gain measurements of Phased Array with various configurations of the Fresnel Lens. Gain measurements are curve fitted to estimate impact of each Fresnel Lens Component

VI. CONCLUSION AND FUTURE WORK
A novel WPT system using a combination of a transmitter Phased Array and a novel EM Fresnel Lens was designed, fabricated, and validated using HFSS simulations and prototype measurement results. The combined planar plus newly developed angular Fresnel lens provides an extra 60% of power gain, compared to a single planar Fresnel Zone lens. Constant power was measured up to 5m with current WPT system. In order to reduce initial transmitter losses, future work will design a Phased array with narrower HPBW along with a larger 2 part Fresnel Lens optimized for the near field, thereby resulting in closer EM capture and reducing loss due to stray EM waves.

REFERENCES

[1] W. C. Brown, "The History of Power Transmission by Radio Waves," in IEEE Transactions on Microwave Theory and Techniques, vol. 32, no. 9, pp. 1230-1242, September 1984
[2] H. D. Hristov, et al, "Design Equation for Multidielectric Fresnel Zone Plate Lens," in IEEE Microwave and Wireless Components Letters, vol. 22, no. 11, pp. 574-576, Nov. 2012,
[3] J. M. Monkevich and G. P. Le Sage, "Design and Fabrication of a Custom-Dielectric Fresnel Multi-Zone Plate Lens Antenna Using Additive Manufacturing Techniques," in IEEE Access, vol. 7, pp. 61452-61460, 2019
[4] N. O. Sokal and A. D. Sokal, "Class E-A new class of high-efficiency tuned single-ended switching power amplifiers," in IEEE Journal of Solid-State Circuits, vol. 10, no. 3, pp. 168-176, June 1975
[5] H. Mardani, N. Buchanan, V. Fusco and U. Naeem, "Increasing the Wireless Power Transfer (WPT) Link Efficiency by High Gain Helices," 2021 IEEE Texas Symposium on Wireless and Microwave Circuits and Systems (WMCS), Waco, TX, USA, 2021, pp. 1-4

Spectrum Analyzer
Fresnel

Transmitter

-35.0

-30.0

-25.0

-20.0

-15.0

-10.0

-5.0

0.0

5.0

0.50 1.00 1.50 2.00 2.50 3.00 3.50 4.00 4.50 5.00

Power Measured (dBm)

Distance (m)

Phased Array w/ Fresnel Lens Rings and Angles

Ph Arr w/out Fresnel Lens
Ph Arr w/ Fresnel Lens
Ph Arr w/ Rings Lens Ph Arr w/ Angles Lens
