Anish-A-18/Wireless-Power-Transmission/FresnelLenses/2024-25/fresnel_design3_Sept2024.xlsx

Sheet: new_freslens1_python grid
 |  | pi |  | 3.142 |  | focal length | 12.500 | grid | 200.00
 |  | c |  | 29980000000 |  | lens thickness | 1.200 | grid delta | 0.0006245833333
 |  | f |  | 2400000000 |  | dielectric max | 5.000
 |  | lambda |  | 12.49166667 |  | focal length x | 31.551
 |  | delta lambda |  | 0.010 |  | ideal phase
 |  |  |  | 3.140 |  | max angle rad | 0.262
 |  |  |  |  |  | max angle | 15.000
 |  |  |  |  |  |  | 2.000
 | cm | cm delta |  |  | lens curve | step amount | final curve | lens y (m) | lens x (m) |  | step lens
1 | 0.000 | 0.000 |  | 0.000 | 0.000 | 0.000 | 2.000 | 0 | 0 | 0 | 0.02 | 0.0 | 0.0 | 0.0 | 32.0 | 0.00 | 0.00 | 0.00 | 20.00 | 170.00
2 | 0.125 | 0.125 | 10.900 | 0.001 | 0.001 | 0.000 | 1.999 | 0.001249166667 | 7.158063724e-06 | 0 | 0.01999284194 | 2.0 | 0.01146054232 | 0.0 | 32.0 | 1.25 | 0.01 | 0.00 | 19.99 | 169.99
3 | 0.250 | 0.125 | 10.901 | 0.002 | 0.003 | 0.000 | 1.997 | 0.002498333333 | 2.863423631e-05 | 0 | 0.01997136576 | 4.0 | 0.04584534166 | 0.0 | 32.0 | 2.50 | 0.03 | 0.00 | 19.97 | 169.97
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
