Anish-A-18/Wireless-Power-Transmission/FresnelLenses/2024-25/FresLens2_concave_10cm_flipped.stl

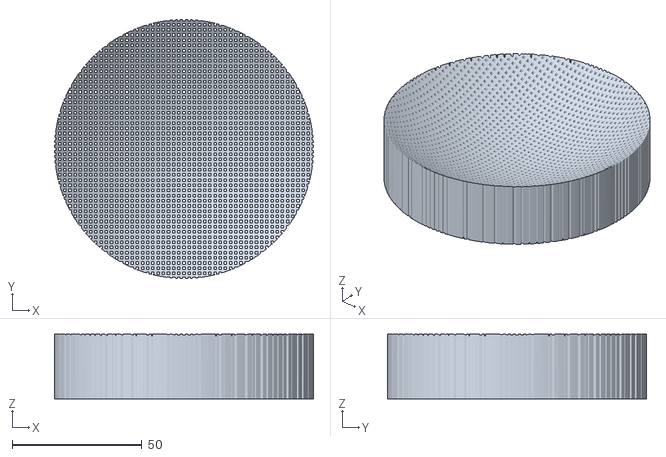
[picture p32: CAD file, 2024-11-11]
FresnelLenses/2024-25/FresLens2_concave_10cm_flipped.stl
100.0 x 100.0 x 25.0
