Anish-A-18/Wireless-Power-Transmission/FresnelLenses/2024-25/FresLens3_PhaseAlign.stl

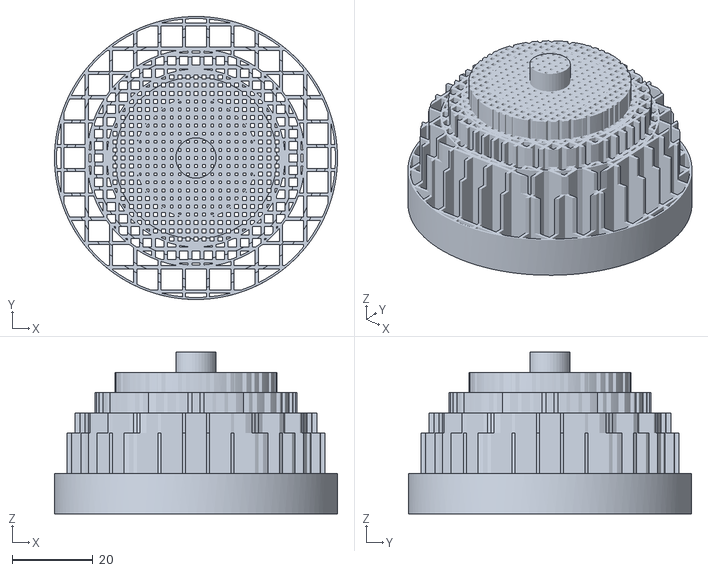
[picture p33: CAD file, 2024-11-11]
FresnelLenses/2024-25/FresLens3_PhaseAlign.stl
70.0 x 70.0 x 40.0
