Anish-A-18/Wireless-Power-Transmission/FresnelLenses/2024-25/FresLens2_10cm.stl

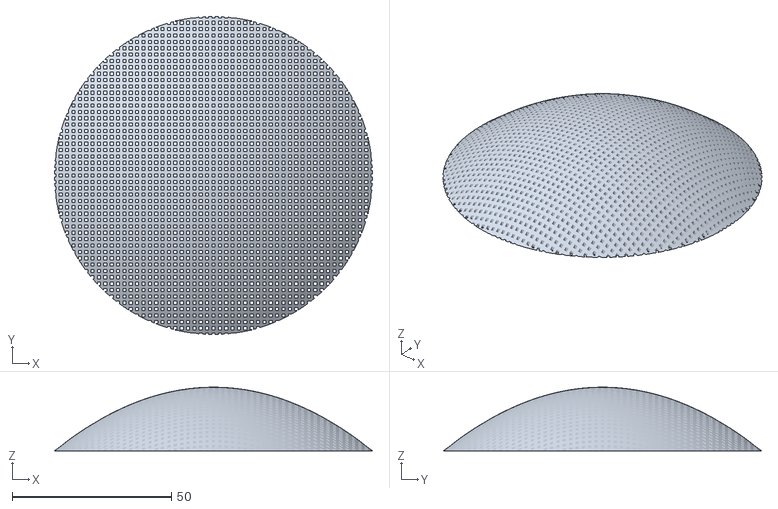
[picture p34: CAD file, 2024-11-09]
FresnelLenses/2024-25/FresLens2_10cm.stl
99.9 x 99.9 x 20.0
