Anish-A-18/Wireless-Power-Transmission/(commit log)

2024-11-09 file rename
    [FresLens2_10cm.stl, fresnel_design2_Sept2024.xlsx]
2024-11-09 Rename Anish Board_2024_janFINAL.pdf to Board2024FINAL.pdf
